ausey00/LBremote/solidworks/Longboard Controller PCB.SLDPRT

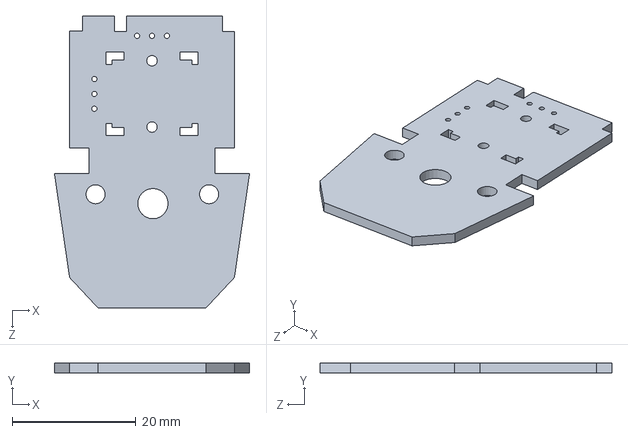
[picture p1: CAD file, 2015-06-10]
solidworks/Longboard Controller PCB.SLDPRT
31.5 x 1.60 x 47.1 mm
