ausey00/LBremote/(list of files, cad)

Other CAD files:
solidworks/Longboard Controller PCB.DXF
