ausey00/LBremote/kicad/LongboardRemote-F_SilkS.pdf

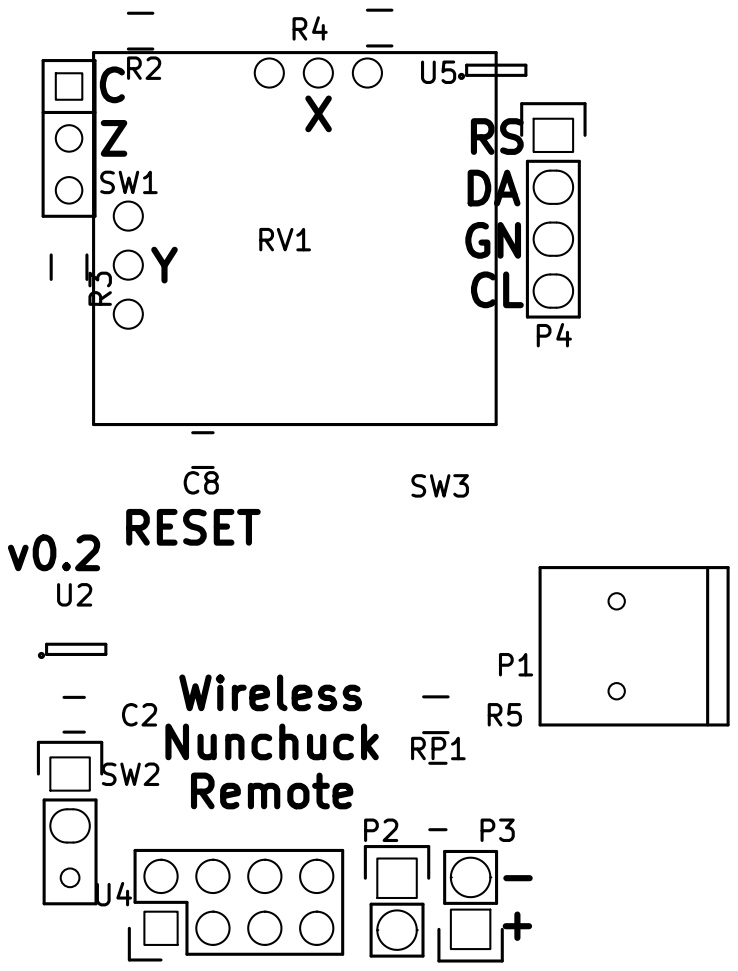
[picture p2: page 1]

ZC Wireless Nunchuck Remote
