ausey00/LBremote/kicad/LongboardRemote-B_Cu.pdf

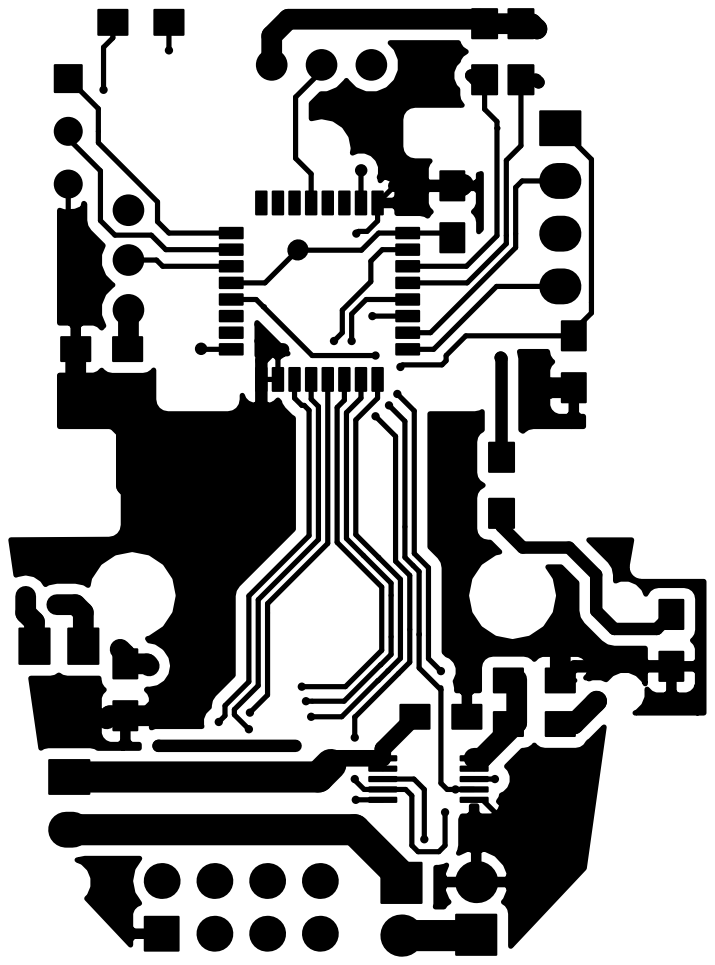
[picture p3: page 1]
