ausey00/LBremote/kicad/LongboardRemote-B_Mask.pdf

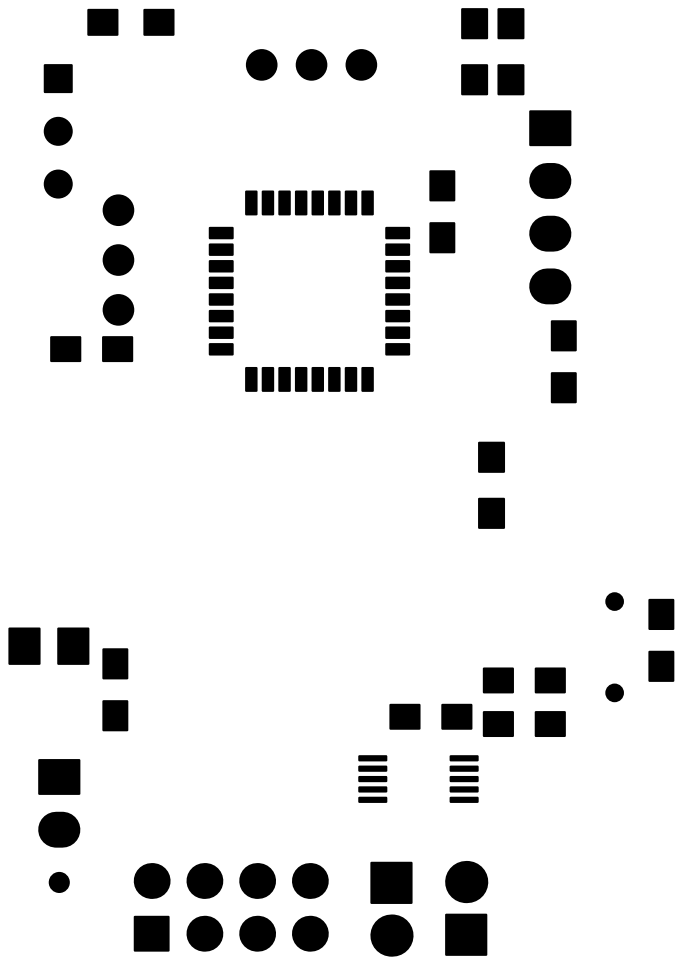
[picture p4: page 1]
