ausey00/LBremote/kicad/LongboardRemote-B_SilkS.pdf

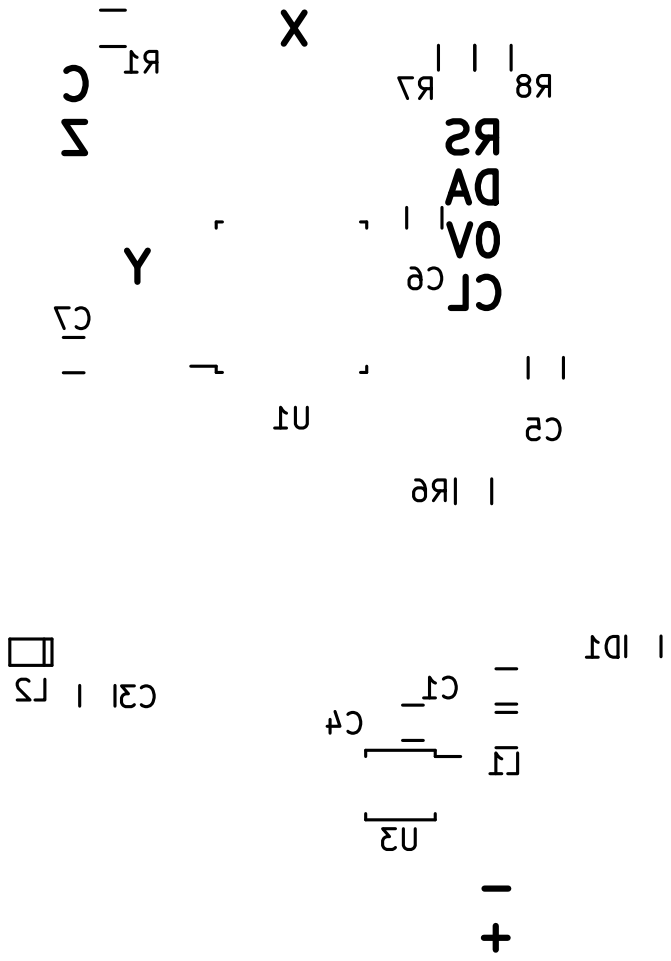
[picture p5: page 1]
