ausey00/LBremote/kicad/LongboardRemote-Edge_Cuts.pdf

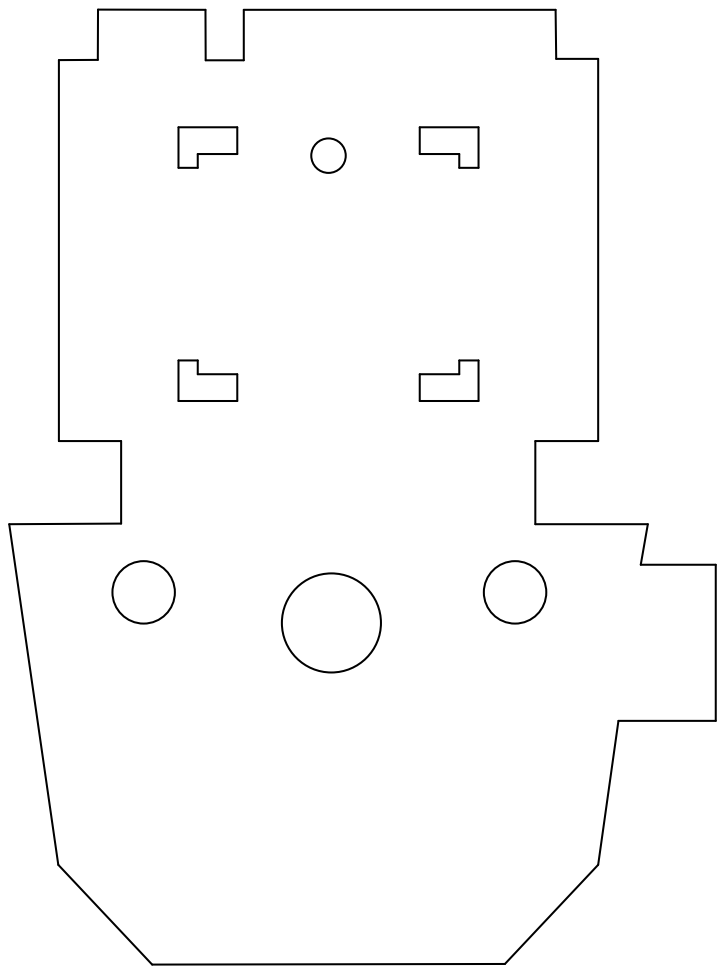
[picture p6: page 1]
