ausey00/LBremote/kicad/LongboardRemote-F_Cu.pdf

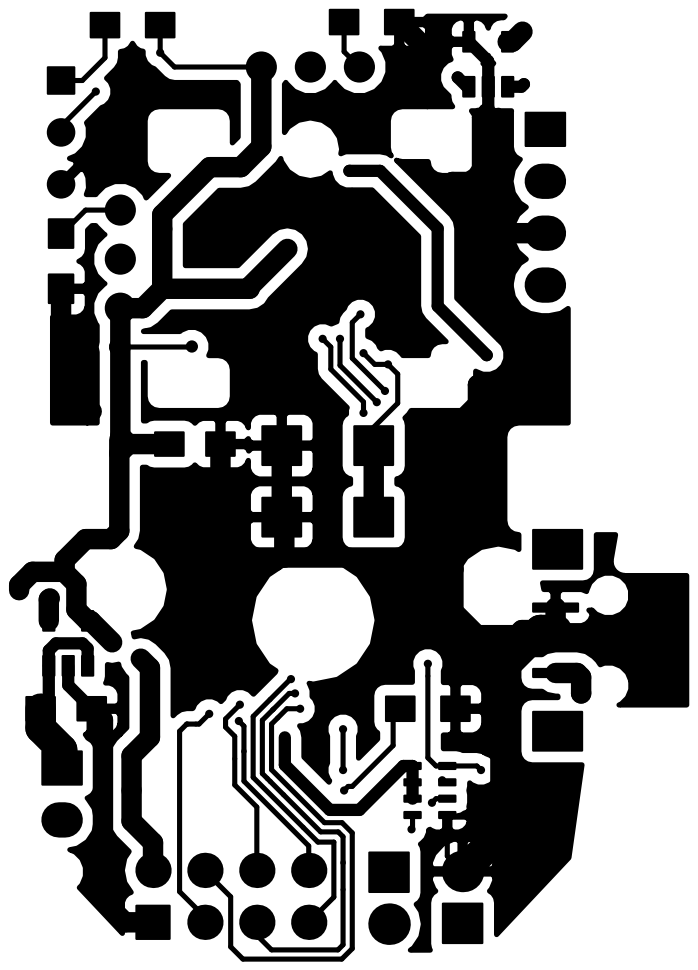
[picture p7: page 1]
