ausey00/LBremote/kicad/LongboardRemote-F_Mask.pdf

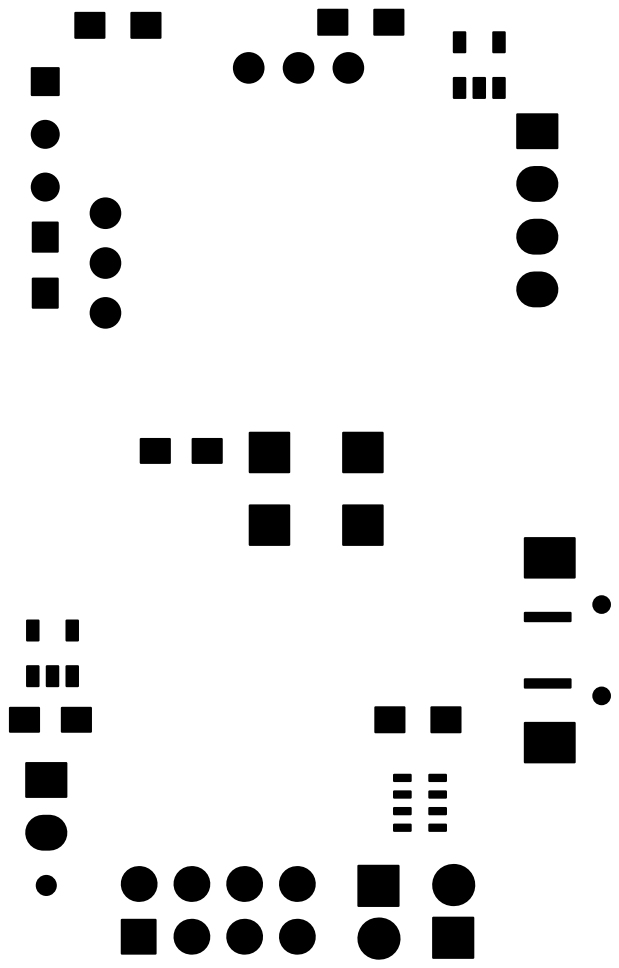
[picture p8: page 1]
