ausey00/LBremote/kicad/LongboardRemote.pdf

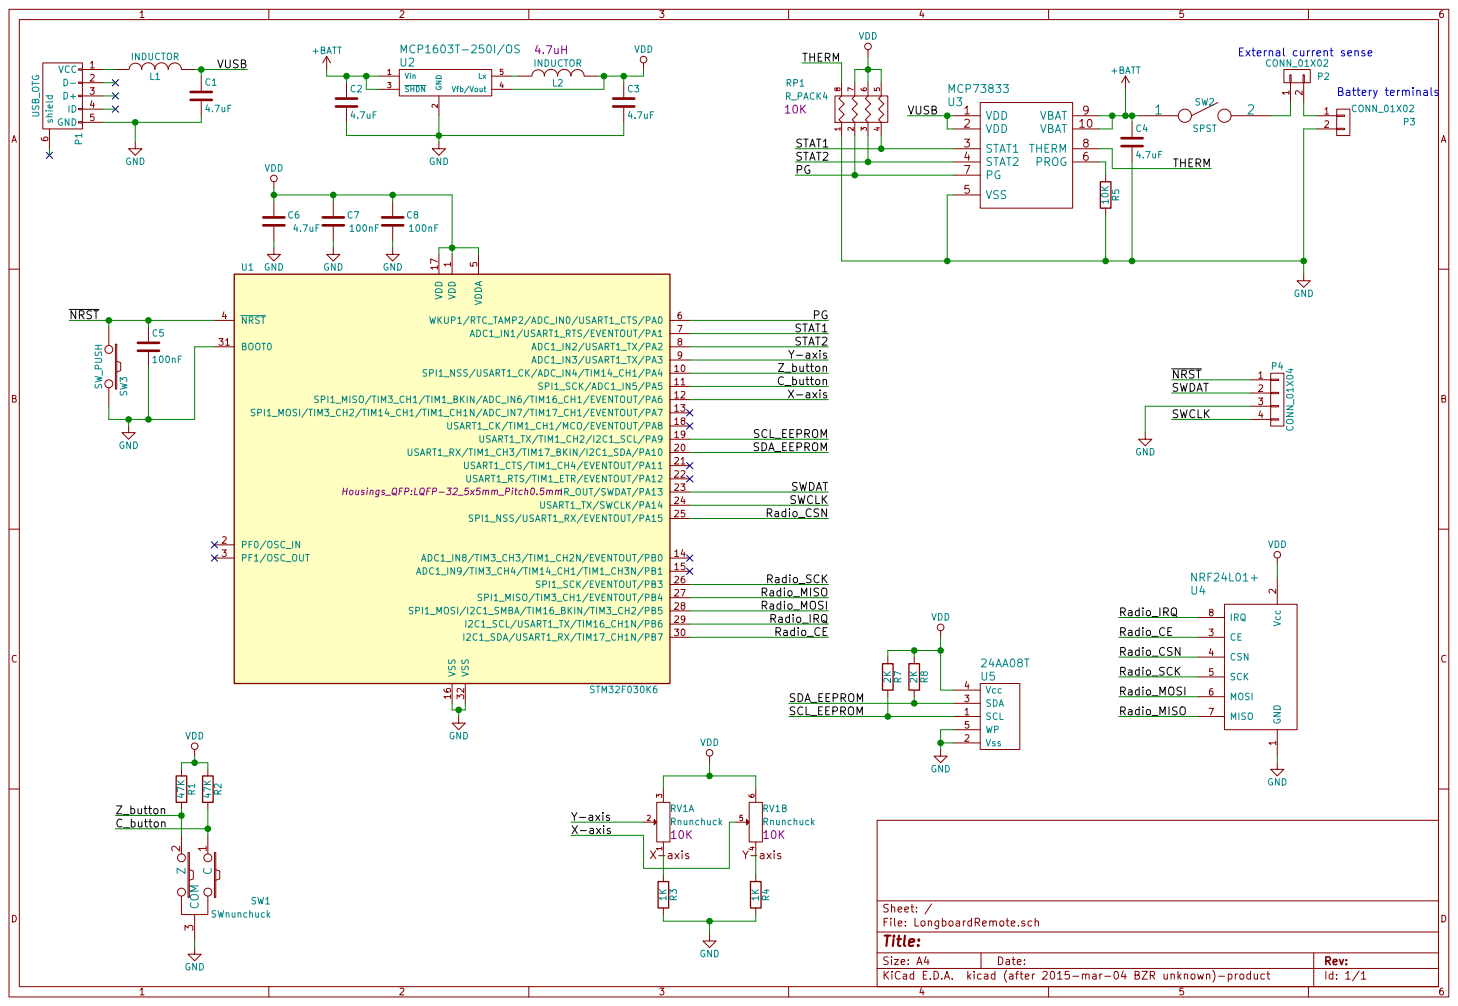
[picture p9: page 1]

Radio_MISO
Radio_MOSI
Radio_IRQ

1 Vcc 2 CE 3 CSN 4 SCK 5 MOSI 6 MISO 7
