ausey00/LBremote/kicad/LongboardRemote.kicad_pcb

## KiCad design kicad/LongboardRemote.kicad_pcb (2015-06-10)

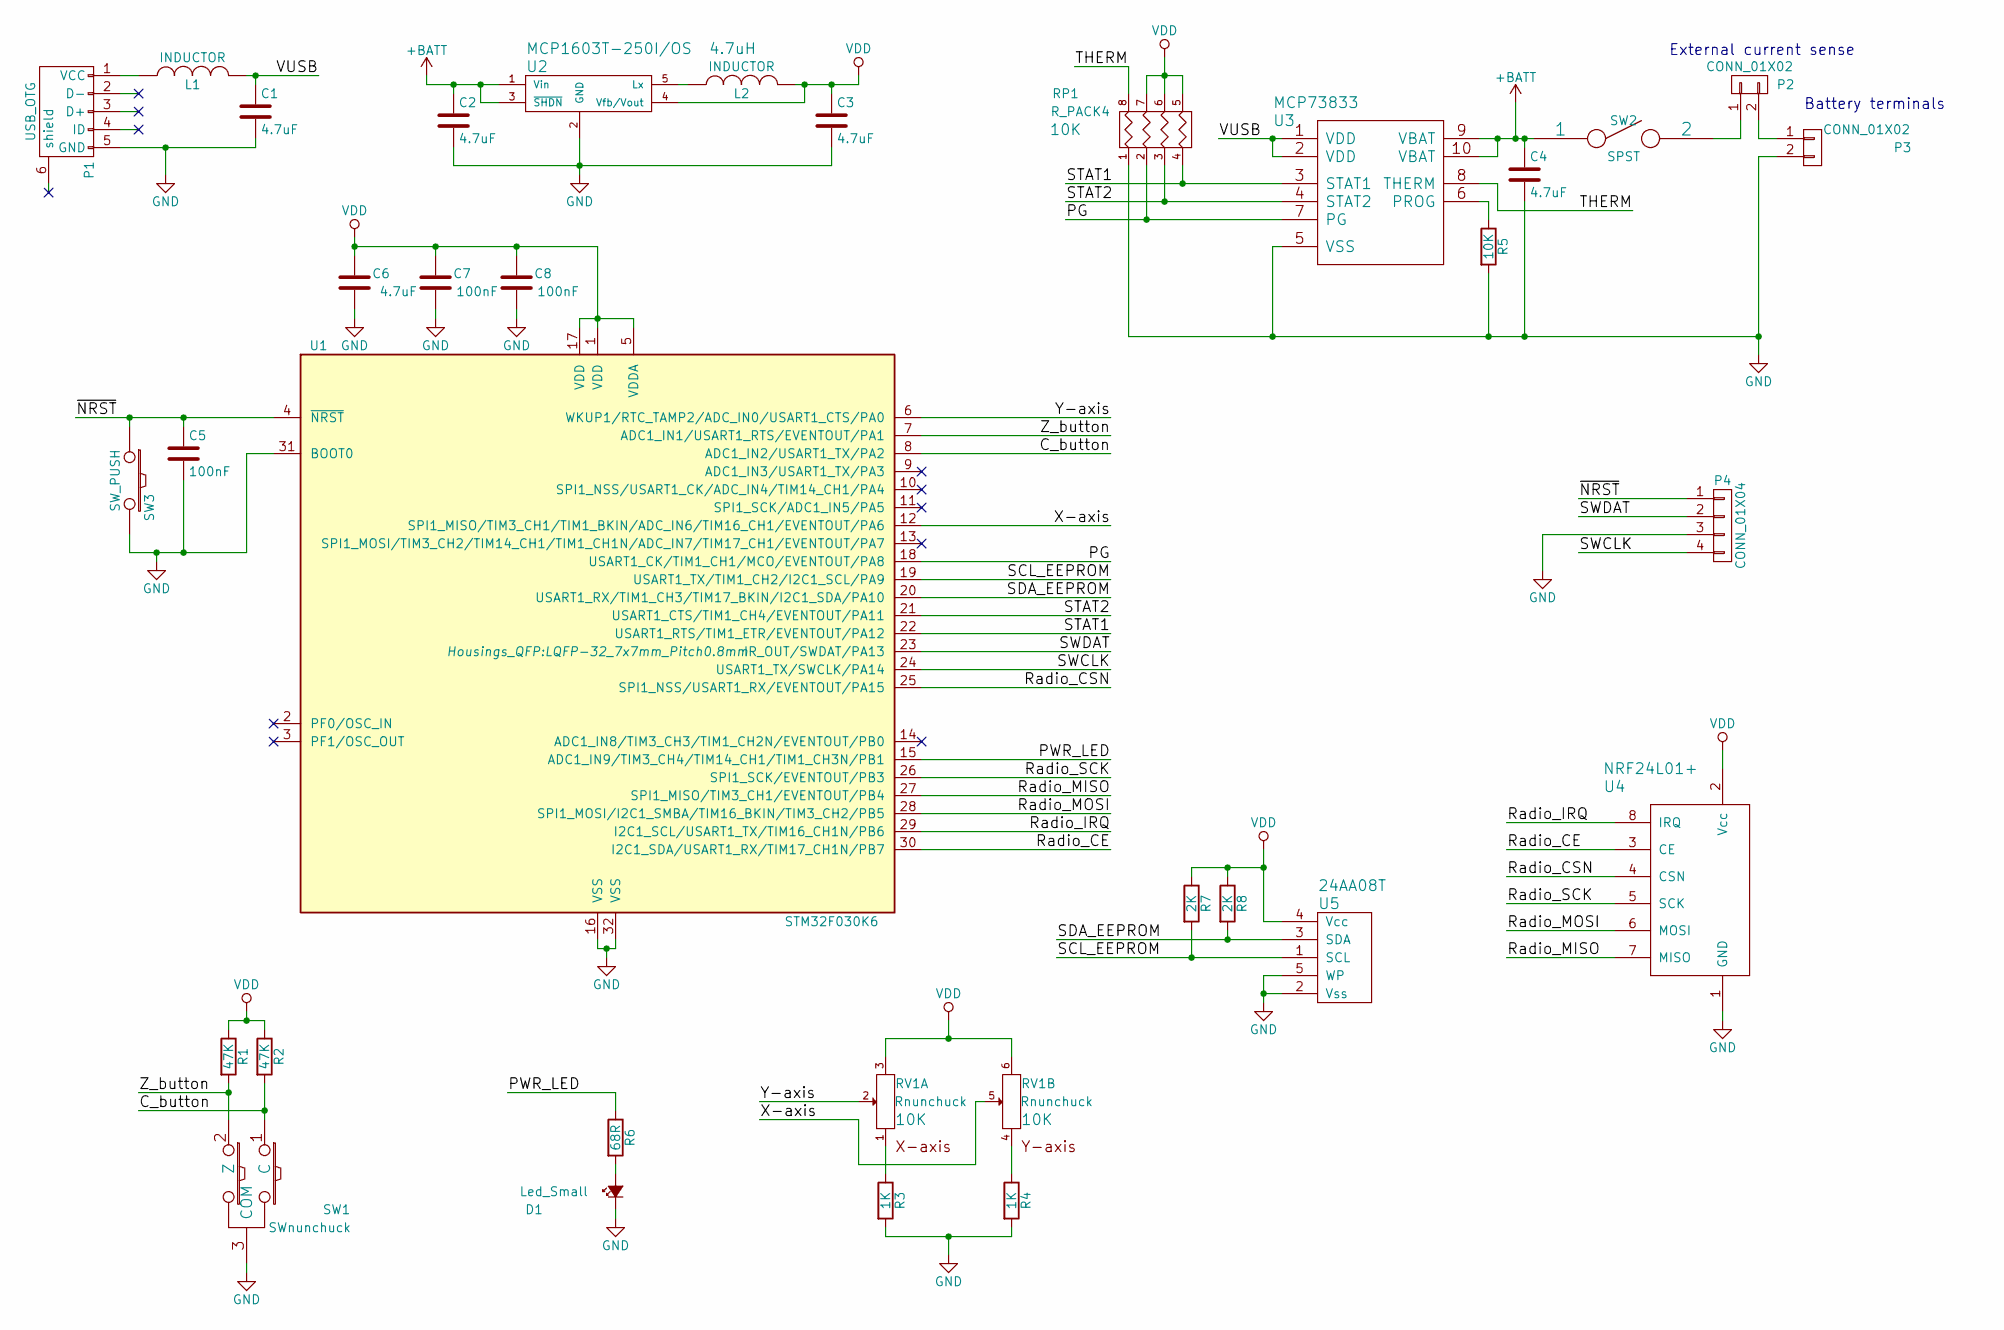
[picture p10: schematic LongboardRemote.sch]

Parts:
C1, C2, C3, C4, C6: 4.7uF; C_0805_HandSoldering
C5, C7, C8: 100nF; C_0805_HandSoldering
D1: Led_Small; C_0805_HandSoldering
L1: INDUCTOR; C_0805_HandSoldering
L2: INDUCTOR; TantalC_SizeR_EIA-2012
P1: USB_OTG; USB_Mini-B
P2, P3: CONN_01X02; Pin_Header_Straight_1x02
P4: CONN_01X04; Socket_Strip_Straight_1x04
R1, R2: 47K; R_0805_HandSoldering
R3, R4: 1K; R_0805_HandSoldering
R5: 10K; R_0805_HandSoldering
R6: 68R; R_0805_HandSoldering
R7, R8: 2K; R_0805_HandSoldering
RP1: R_PACK4; R_Array_Concave_4x0603
RV1: Rnunchuck
SW1: SWnunchuck; SW_Micro_SPST
SW2: SPST; Pin_Header_Straight_1x03
SW3: SW_PUSH; SW_SMD_TACT_5.15x4.6
U1: STM32F030K6; LQFP-32_7x7mm_Pitch0.8mm
U2: MCP1603T-250I/OS; SOT-23-5
U3: MCP73833; MSOP-10_3x3mm_Pitch0.5mm
U4: NRF24L01+; Pin_Header_Straight_2x04
U5: 24AA08T; SOT-23-5

Connections:
+BATT: C2.1, C4.1, SW2.1, U2.1 (Vin), U2.3 (~SHDN), U3.9 (VBAT), U3.10 (VBAT)
/C_button: R2.2, SW1.1 (C), U1.8 (ADC1_IN2/USART1_TX/PA2)
/PG: RP1.2, U1.18 (USART1_CK/TIM1_CH1/MCO/EVENTOUT/PA8), U3.7 (PG)
/PWR_LED: R6.1, U1.15 (ADC1_IN9/TIM3_CH4/TIM14_CH1/TIM1_CH3N/P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)
/Radio_CE: U1.30 (I2C1_SDA/USART1_RX/TIM17_CH1N/PB7), U4.3 (CE)
/Radio_CSN: U1.25 (SPI1_NSS/USART1_RX/EVENTOUT/PA15), U4.4 (CSN)
/Radio_IRQ: U1.29 (I2C1_SCL/USART1_TX/TIM16_CH1N/PB6), U4.8 (IRQ)
/Radio_MISO: U1.27 (SPI1_MISO/TIM3_CH1/EVENTOUT/PB4), U4.7 (MISO)
/Radio_MOSI: U1.28 (SPI1_MOSI/I2C1_SMBA/TIM16_BKIN/TIM3_CH2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), U4.6 (MOSI)
/Radio_SCK: U1.26 (SPI1_SCK/EVENTOUT/PB3), U4.5 (SCK)
/SCL_EEPROM: R7.2, U1.19 (USART1_TX/TIM1_CH2/I2C1_SCL/PA9), U5.1 (SCL)
/SDA_EEPROM: R8.2, U1.20 (USART1_RX/TIM1_CH3/TIM17_BKIN/I2C1_SDA/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), U5.3 (SDA)
/STAT1: RP1.4, U1.22 (USART1_RTS/TIM1_ETR/EVENTOUT/PA12), U3.3 (STAT1)
/STAT2: RP1.3, U1.21 (USART1_CTS/TIM1_CH4/EVENTOUT/PA11), U3.4 (STAT2)
/SWCLK: P4.4, U1.24 (USART1_TX/SWCLK/PA14)
/SWDAT: P4.2, U1.23 (IR_OUT/SWDAT/PA13)
/THERM: RP1.8 (R1), U3.8 (THERM)
/VUSB: C1.1, L1.2, U3.1 (VDD), U3.2 (VDD)
/X-axis: RV1.5, U1.12 (SPI1_MISO/TIM3_CH1/TIM1_BKIN/ADC_IN6/TI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)
/Y-axis: RV1.2 (5), U1.6 (WKUP1/RTC_TAMP2/ADC_IN0/USART1_CTS/PA0)
/Z_button: R1.2, SW1.2 (Z), U1.7 (ADC1_IN1/USART1_RTS/EVENTOUT/PA1)
/~NRST: C5.1, P4.1, SW3.1, U1.4 (~NRST)
GND: C1.2, C2.2, C3.2, C4.2, C5.2, C6.1, C7.1, C8.1, D1.1 (K), P1.5 (GND), P3.2, P4.3, R3.2, R4.2, R5.2, RP1.1, SW1.3 (COM), SW3.2, U1.16 (VSS), U1.31 (BOOT0), U1.32 (VSS), U2.2 (GND), U3.5 (VSS), U4.1 (GND), U5.2 (Vss), U5.5 (WP)
unnamed: D1.2 (A), R6.2
unnamed: L1.1, P1.1 (VCC)
unnamed: L2.1, U2.5 (Lx)
unnamed: P2.1, SW2.2
unnamed: P2.2, P3.1
unnamed: R3.1, RV1.1 (4)
unnamed: R4.1, RV1.4
unnamed: R5.1, U3.6 (PROG)
VDD: C3.1, C6.2, C7.2, C8.2, L2.2, R1.1, R2.1, R7.1, R8.1, RP1.5 (R4), RP1.6 (R3), RP1.7 (R2), RV1.3 (6), RV1.6, U1.1 (VDD), U1.5 (VDDA), U1.17 (VDD), U2.4 (Vfb/Vout), U4.2 (Vcc), U5.4 (Vcc)

Notes on the sheet:
External current sense
Battery terminals

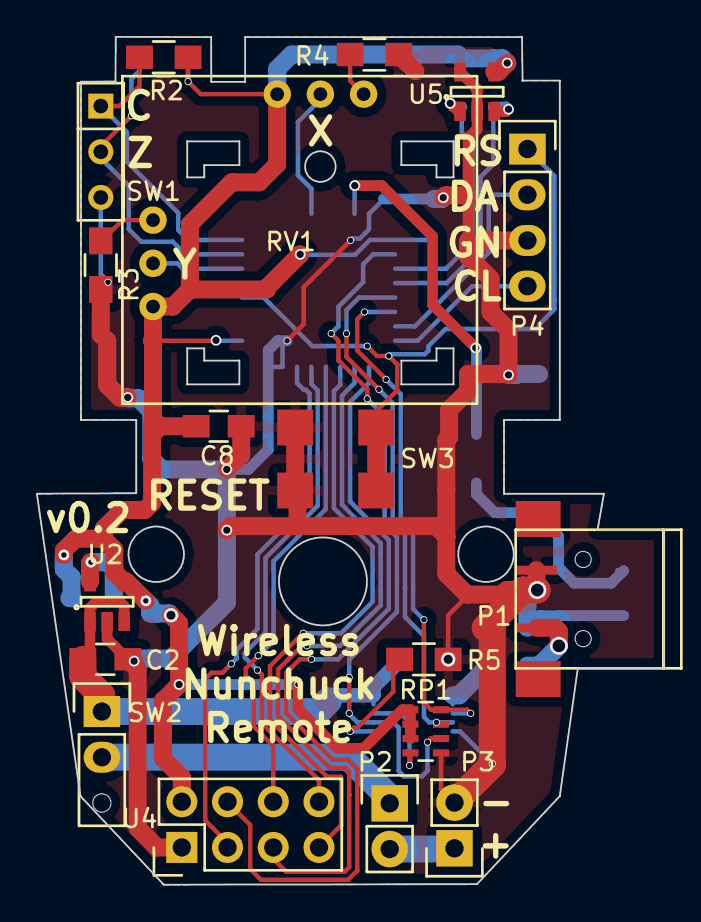
[picture p11: board LongboardRemote.kicad_pcb from above]

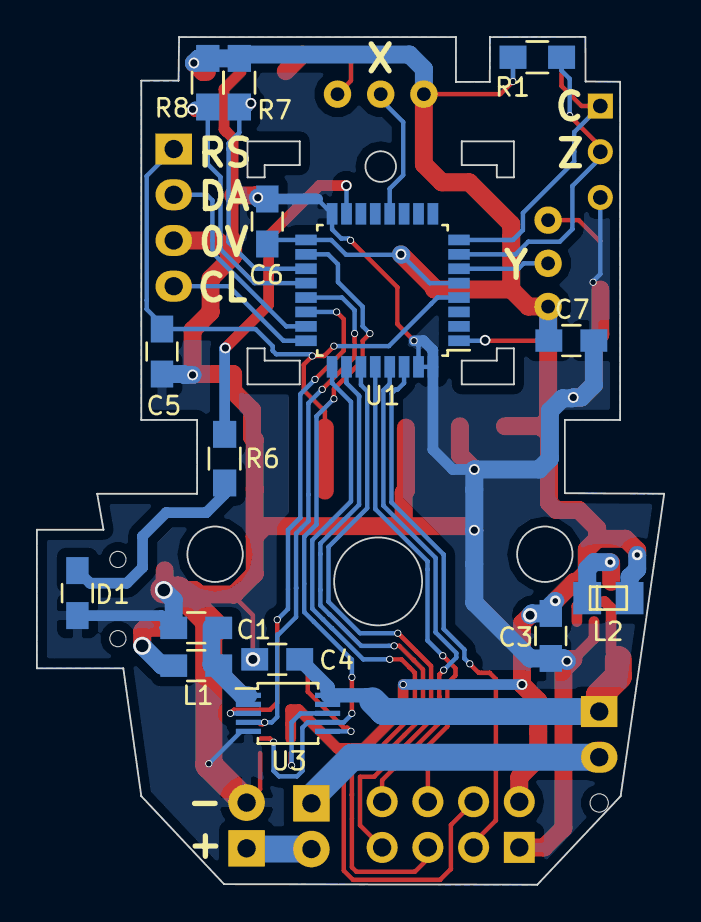
[picture p12: board LongboardRemote.kicad_pcb from below]

Board: 2 copper layers, 34.9 x 47.1 mm, 33 parts (15 on the bottom side), 32 nets.
